Greg-R/T41_2_lpf/README.md

The documentation for this module is located here:

<https://kf5n.com/t41-2/t41-2_lpf/>
