Greg-R/T41_2_lpf/doc/T41_2_lpf.pdf

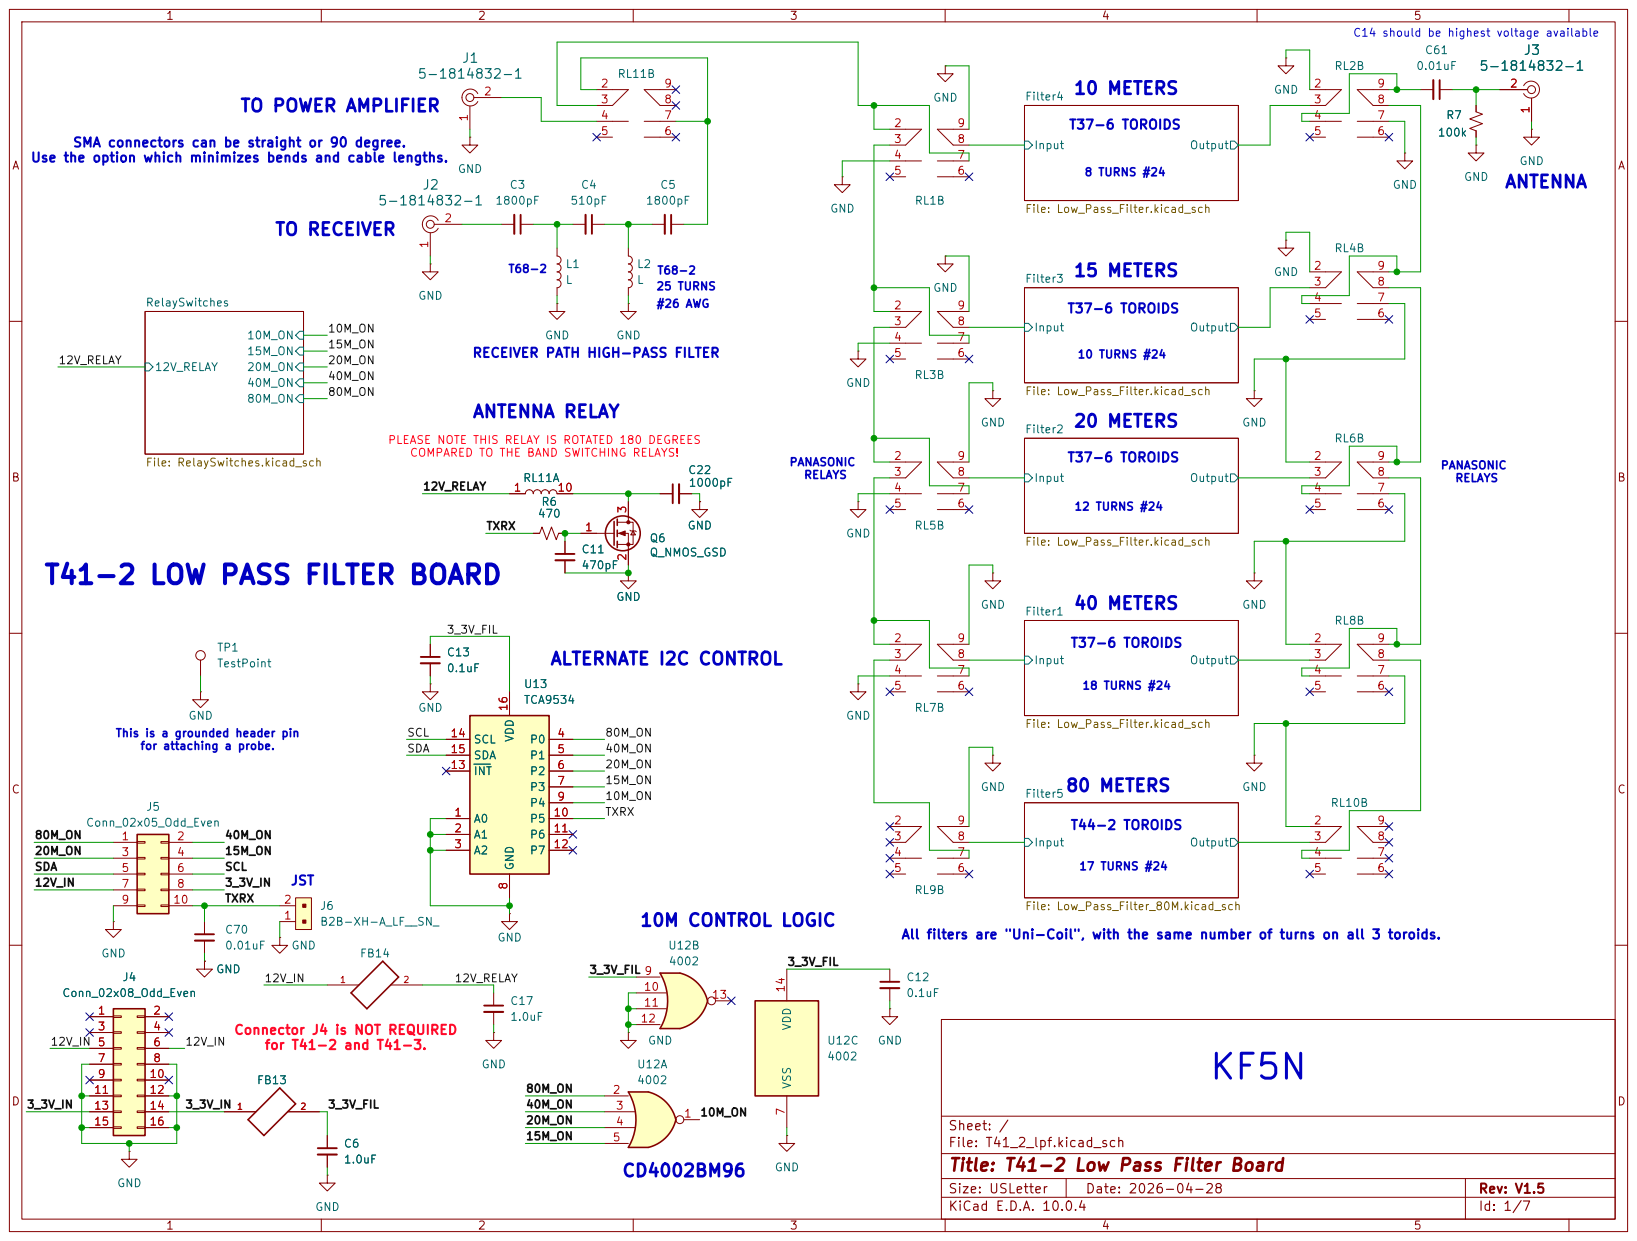
[picture p1: page 1]

C14 should be highest voltage available KF5N

SMA connectors can be straight or 90 degree.
Use the option which minimizes bends and cable lengths.

T68-2 ANTENNA RELAY
T68-2 RECEIVER PATH HIGH-PASS FILTER

T41-2 LOW PASS FILTER BOARD

This is a grounded header pin

All filters are "Uni-Coil", with the same number of turns on all 3 toroids.

Connector J4 is NOT REQUIRED
for T41-2 and T41-3.

Sheet: /
File: T41_2_lpf.kicad_sch
Title: T41-2 Low Pass Filter Board

Size: USLetter | Rev: V1.5
KiCad E.D.A. 10.0.4 | Id: 1/7

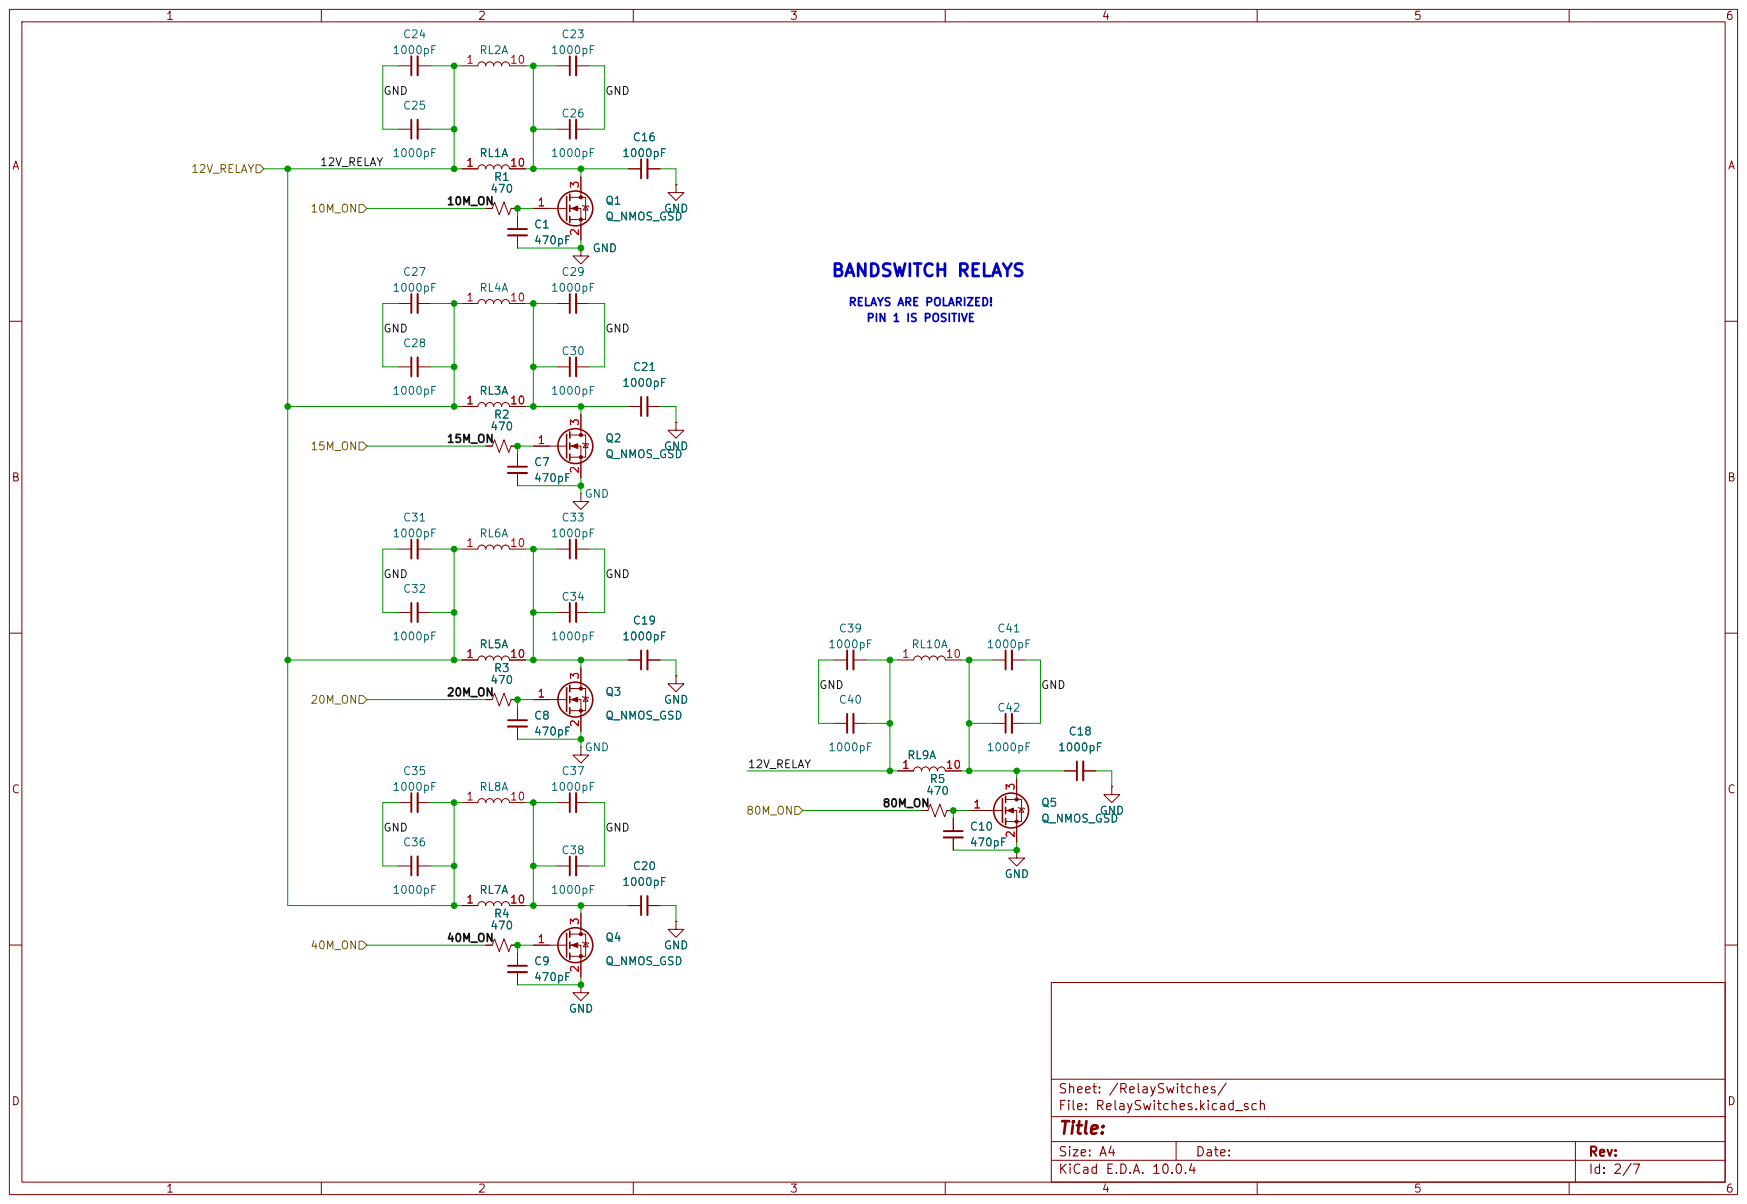
[picture p2: page 2]

RELAYS ARE POLARIZED! PIN 1 IS POSITIVE BANDSWITCH RELAYS

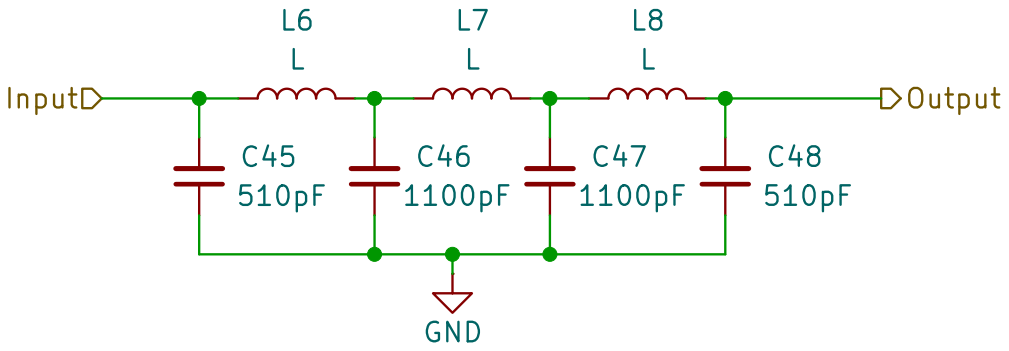
[picture p3: page 3]

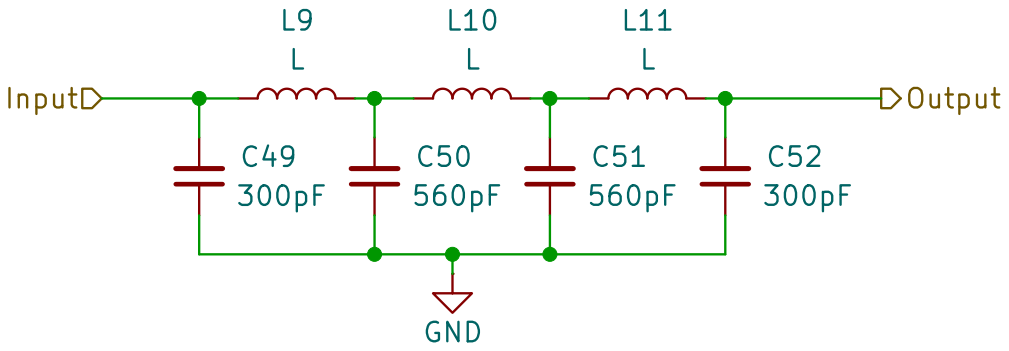
[picture p4: page 4]

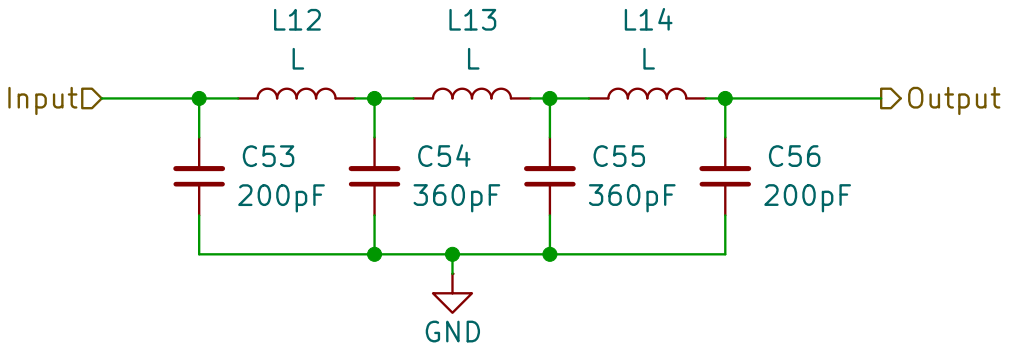
[picture p5: page 5]

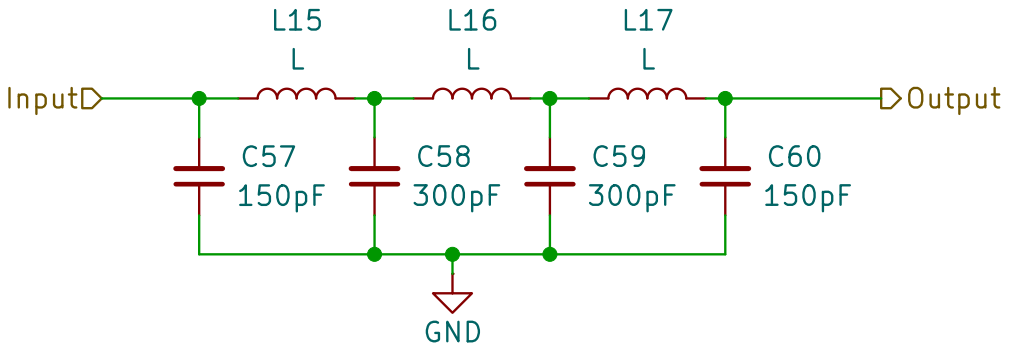
[picture p6: page 6]

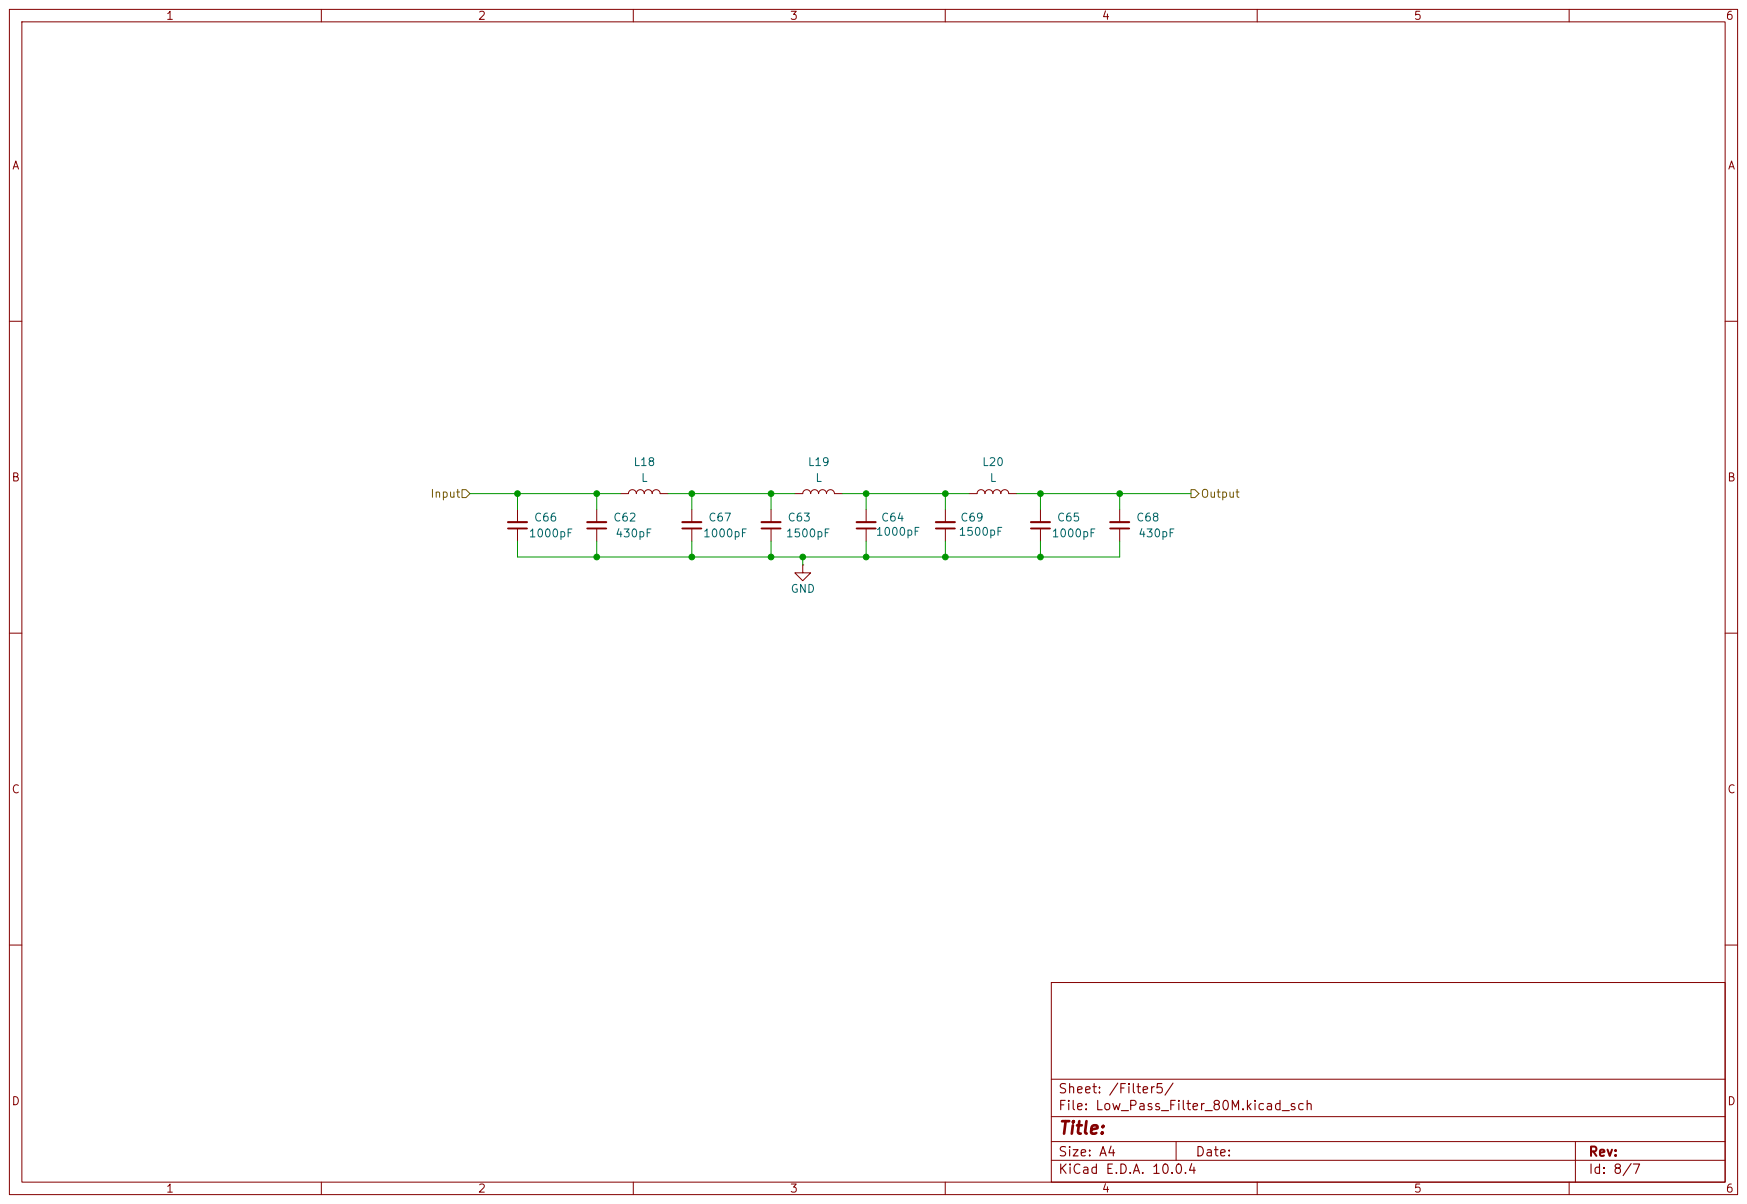
[picture p7: page 7]
