Greg-R/T41_2_lpf/(list of files, drawings)

Other design files:
T41_2_lpf.dsn
