Greg-R/T41_2_lpf/T41_2_lpf.kicad_pcb

## KiCad design T41_2_lpf.kicad_pcb (2026-07-20)

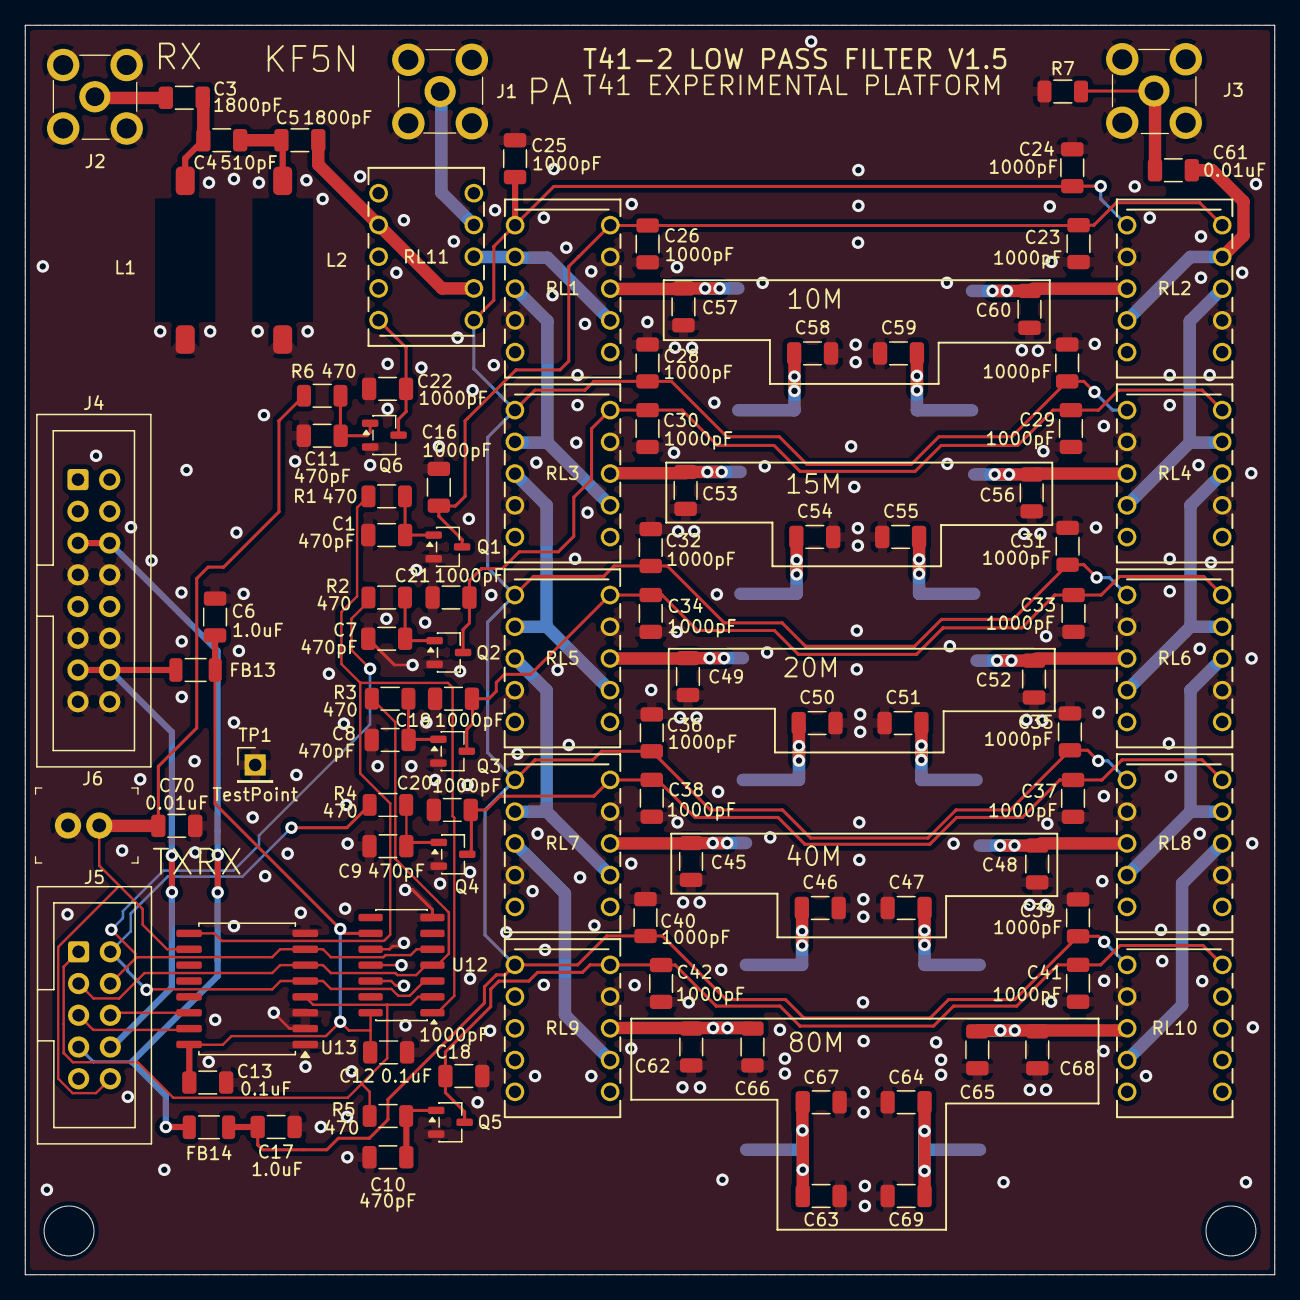
[picture p8: board T41_2_lpf.kicad_pcb from above]

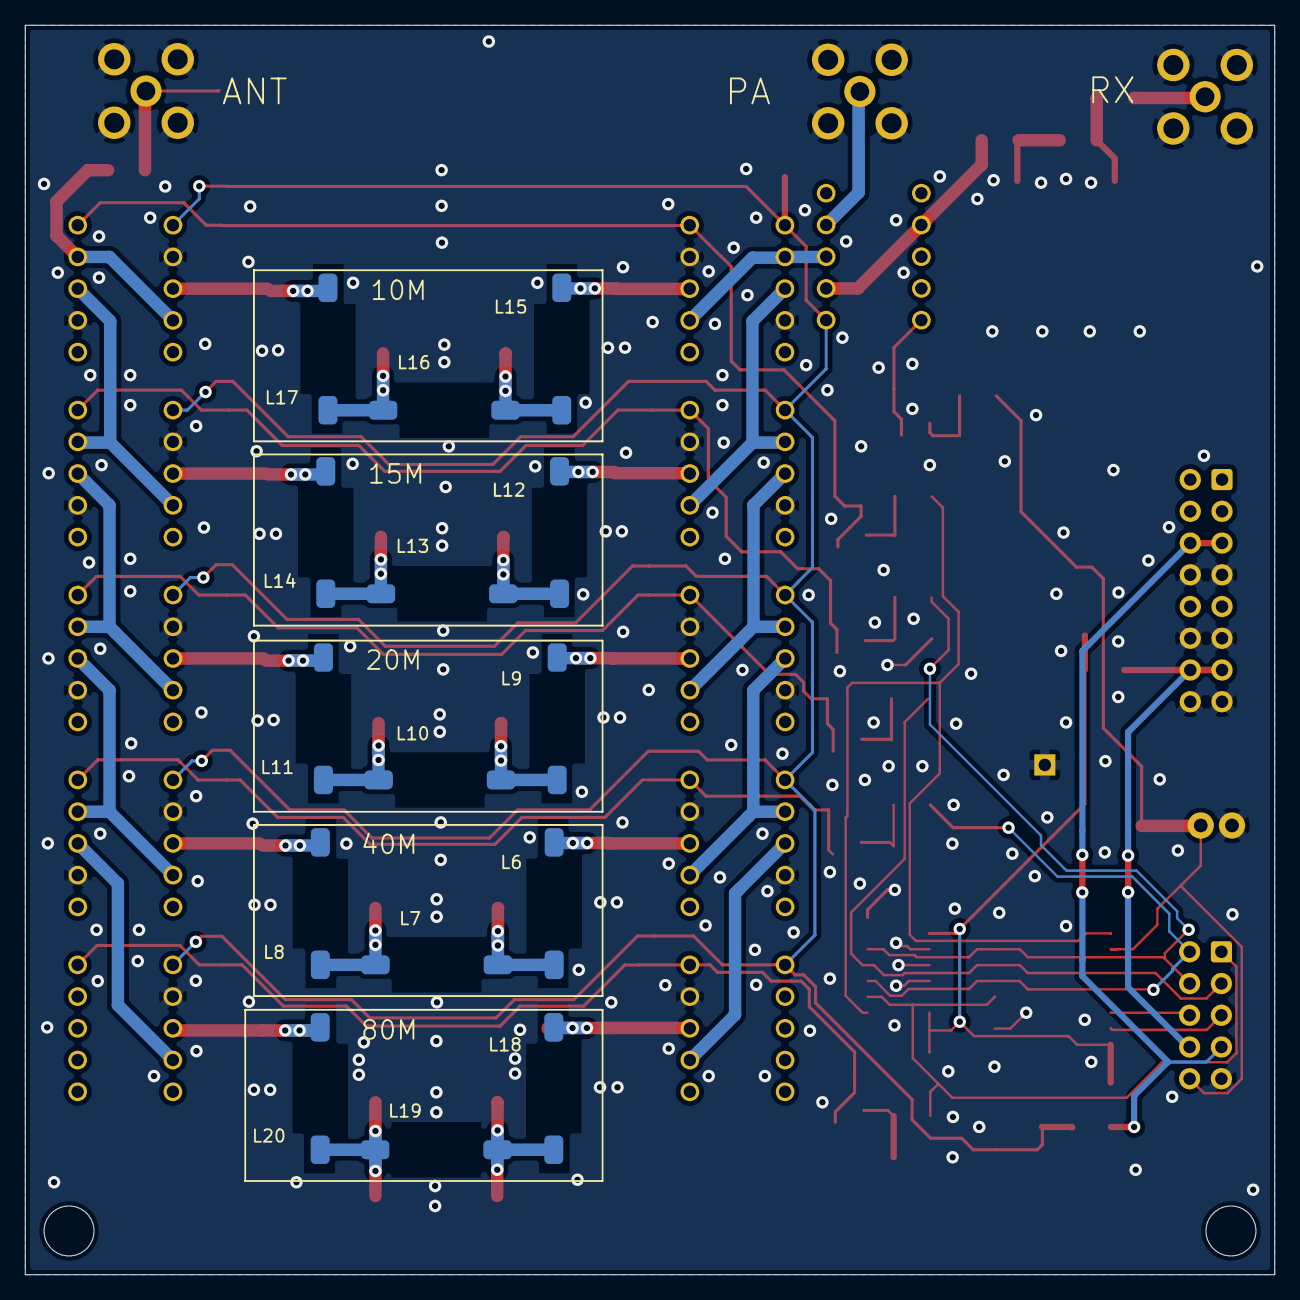
[picture p9: board T41_2_lpf.kicad_pcb from below]

Board: 2 copper layers, 100.0 x 100.0 mm, 117 parts (15 on the bottom side), 61 nets.

Parts:
C1, C7, C8, C9, C10, C11: 470pF; C_1206_3216Metric
C3, C5: 1800pF; C_1206_3216Metric
C4, C45, C48: 510pF; C_1206_3216Metric
C6, C17: 1.0uF; C_1206_3216Metric
C12, C13: 0.1uF; C_1206_3216Metric
C16, C18, C19, C20, C21, C22, C23, C24, C25, C26, C27, C28, C29, C30, C31, C32, C33, C34, C35, C36, C37, C38, C39, C40, C41, C42, C64, C65, C66, C67: 1000pF; C_1206_3216Metric
C46, C47: 1100pF; C_1206_3216Metric
C49, C52, C58, C59: 300pF; C_1206_3216Metric
C50, C51: 560pF; C_1206_3216Metric
C53, C56: 200pF; C_1206_3216Metric
C54, C55: 360pF; C_1206_3216Metric
C57, C60: 150pF; C_1206_3216Metric
C61, C70: 0.01uF; C_1206_3216Metric
C62, C68: 430pF; C_1206_3216Metric
C63, C69: 1500pF; C_1206_3216Metric
FB13, FB14: 28F0121-0SR-10; L_1206_3216Metric
J1, J2, J3: 5-1814832-1; RF_SMA_Vertical_5-1814832-1
J4: Conn_02x08_Odd_Even; IDC-Header_2x08_P2.54mm_Vertical
J5: Conn_02x05_Odd_Even; IDC-Header_2x05_P2.54mm_Vertical
J6: B2B-XH-A_LF__SN_; PinHeader_1x2_P2.5mm_Drill1.1mm
L1, L2: L; Toroid_SMD_T68
L6, L7, L8, L9, L10, L11, L12, L13, L14, L15, L16, L17, L18, L19, L20: L; Toroid_SMD_Thin
Q1, Q2, Q3, Q4, Q5, Q6: Q_NMOS_GSD; SOT-23-3
R1, R2, R3, R4, R5, R6: 470; R_1206_3216Metric
R7: 100k; R_1206_3216Metric
RL1, RL2, RL3, RL4, RL5, RL6, RL7, RL8, RL9, RL10, RL11: RELAY_TQ2_PAN
TP1: TestPoint; PinHeader_1x01_P2.54mm_Vertical
U12: 4002; SOIC-14_3.9x8.7mm_P1.27mm
U13: TCA9534; SOIC-16W_7.5x10.3mm_P1.27mm

Connections:
/3_3V_FIL: C6.1, C12.1, C13.1, FB13.2, U12.9, U12.14 (VDD), U13.16 (VDD)
/3_3V_IN: FB13.1, J4.13, J4.14, J5.8
/10M_ON: R1.1, U12.1, U13.9 (P4)
/12V_IN: FB14.1, J4.5, J4.6, J5.7
/12V_RELAY: C17.1, C24.2, C25.2, C27.2, C28.2, C31.2, C32.2, C35.2, C36.2, C39.2, C40.2, FB14.2, RL1.1, RL2.1, RL3.1, RL4.1, RL5.1, RL6.1, RL7.1, RL8.1, RL9.1, RL10.1, RL11.1
/15M_ON: J5.4, R2.1, U12.5, U13.7 (P3)
/20M_ON: J5.3, R3.1, U12.4, U13.6 (P2)
/40M_ON: J5.2, R4.1, U12.3, U13.5 (P1)
/80M_ON: J5.1, R5.1, U12.2, U13.4 (P0)
/Filter1/Input: C45.2, L6.1, RL7.8
/Filter1/Output: C48.2, L8.2, RL8.3
/Filter2/Input: C49.2, L9.1, RL5.8
/Filter2/Output: C52.2, L11.2, RL6.3
/Filter3/Input: C53.2, L12.1, RL3.8
/Filter3/Output: C56.2, L14.2, RL4.3
/Filter4/Input: C57.2, L15.1, RL1.8
/Filter4/Output: C60.2, L17.2, RL2.3
/Filter5/Input: C62.2, C66.2, L18.1, RL9.8
/Filter5/Output: C65.2, C68.2, L20.2, RL10.3
/SCL: J5.6, U13.14 (SCL)
/SDA: J5.5, U13.15 (SDA)
/TXRX: C70.1, J5.10, J6.2, R6.1, U13.10 (P5)
GND: C1.2, C6.2, C7.2, C8.2, C9.2, C10.2, C11.2, C12.2, C13.2, C16.2, C17.2, C18.2, C19.2, C20.2, C21.2, C22.2, C23.2, C24.1, C25.1, C26.2, C27.1, C28.1, C29.2, C30.2, C31.1, C32.1, C33.2, C34.2, C35.1, C36.1, C37.2, C38.2, C39.1, C40.1, C41.2, C42.2, C45.1, C46.1, C47.1, C48.1, C49.1, C50.1, C51.1, C52.1, C53.1, C54.1, C55.1, C56.1, C57.1, C58.1, C59.1, C60.1, C62.1, C63.1, C64.1, C65.1, C66.1, C67.1, C68.1, C69.1, C70.2, J1.1, J2.1, J3.1, J4.7, J4.8, J4.11, J4.12, J4.15, J4.16, J5.9, J6.1, L1.2, L2.2, Q1.2 (S), Q2.2 (S), Q3.2 (S), Q4.2 (S), Q5.2 (S), Q6.2 (S), R7.1, RL1.4, RL1.9, RL2.2, RL2.7, RL3.4, RL3.9, RL4.2, RL4.7, RL5.4, RL5.9, RL6.2, RL6.7, RL7.4, RL7.9, RL8.2, RL8.7, RL9.9, RL10.2, TP1.1 (1_1), U12.7 (VSS), U12.10, U12.11, U12.12, U13.1 (A0), U13.2 (A1), U13.3 (A2), U13.8 (GND)
unnamed: C3.1, C4.2, L1.1
unnamed: C3.2, J2.2
unnamed: C4.1, C5.2, L2.1
unnamed: C5.1, RL11.2, RL11.7
unnamed: C46.2, L6.2, L7.1
unnamed: C47.2, L7.2, L8.1
unnamed: C50.2, L9.2, L10.1
unnamed: C51.2, L10.2, L11.1
unnamed: C54.2, L12.2, L13.1
unnamed: C55.2, L13.2, L14.1
unnamed: C58.2, L15.2, L16.1
unnamed: C59.2, L16.2, L17.1
unnamed: C61.1, J3.2, R7.2
unnamed: C61.2, RL2.4, RL2.9
unnamed: C63.2, C67.2, L18.2, L19.1
unnamed: C64.2, C69.2, L19.2, L20.1
unnamed: J1.2, RL11.4
unnamed: C16.1, C23.1, C26.1, Q1.3 (D), RL1.10, RL2.10
unnamed: C1.1, Q1.1 (G), R1.2
unnamed: C21.1, C29.1, C30.1, Q2.3 (D), RL3.10, RL4.10
unnamed: C7.1, Q2.1 (G), R2.2
unnamed: C19.1, C33.1, C34.1, Q3.3 (D), RL5.10, RL6.10
unnamed: C8.1, Q3.1 (G), R3.2
unnamed: C20.1, C37.1, C38.1, Q4.3 (D), RL7.10, RL8.10
unnamed: C9.1, Q4.1 (G), R4.2
unnamed: C18.1, C41.1, C42.1, Q5.3 (D), RL9.10, RL10.10
unnamed: C10.1, Q5.1 (G), R5.2
unnamed: C22.1, Q6.3 (D), RL11.10
unnamed: C11.1, Q6.1 (G), R6.2
unnamed: RL1.2, RL1.7, RL11.3
unnamed: RL1.3, RL3.2, RL3.7
unnamed: RL2.8, RL4.4, RL4.9
unnamed: RL3.3, RL5.2, RL5.7
unnamed: RL4.8, RL6.4, RL6.9
unnamed: RL5.3, RL7.2, RL7.7
unnamed: RL6.8, RL8.4, RL8.9
unnamed: RL7.3, RL9.7
unnamed: RL8.8, RL10.4
