Greg-R/T41_2_lpf/doc/T41_2_lpf_cap_placement_guide.pdf

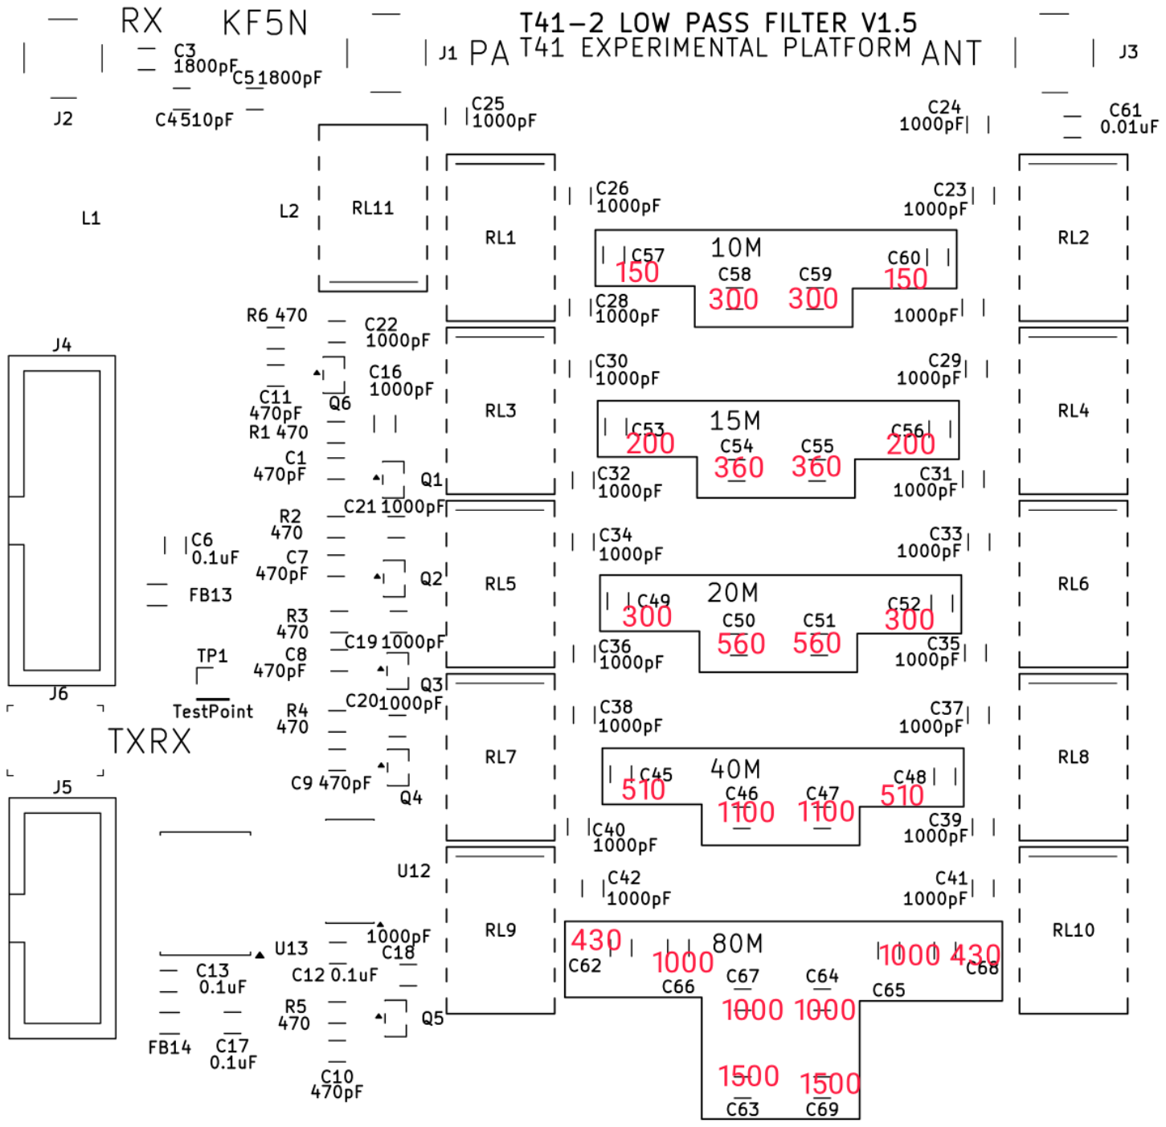
[picture p10: page 1]
