Greg-R/T41_2_lpf/(commit log)

2024-12-01 Initial commit.
    [10M_Filter.kicad_sch, 15M_Filter.kicad_sch, 20M_Filter.kicad_sch, 40M_Filter.kicad_sch, 80M_Filter.kicad_sch, Low_Pass_Filter.kicad_sch, RelaySwitches.kicad_sch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]
2024-12-02 Ready for fab.
    [T41_2_lpf-B_Cu.gbr, T41_2_lpf-B_Mask.gbr, T41_2_lpf-B_Silkscreen.gbr, T41_2_lpf-Edge_Cuts.gbr, T41_2_lpf-F_Cu.gbr, T41_2_lpf-F_Mask.gbr, T41_2_lpf-F_Silkscreen.gbr, T41_2_lpf-NPTH.drl]
2025-12-28 Commit just prior to pushing to Github. Design not complete.
    [Low_Pass_Filter.kicad_sch, RelaySwitches.kicad_sch, T41_2_lpf.kicad_pcb, T41_2_lpf.kicad_sch]
2026-03-15 Trying to improve schematic by adding capacitor values to all bands.
    [Low_Pass_Filter.kicad_sch, T41_2_lpf.kicad_sch]
2026-03-21 T41-2 LPF V1.4 to fab.
    [Low_Pass_Filter.kicad_sch, RelaySwitches.kicad_sch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]
2026-04-08 Work in progress just prior to publish.
    [Low_Pass_Filter.kicad_sch, RelaySwitches.kicad_sch, T41_2_lpf.kicad_sch]
2026-04-15 Ready to fab version 1.5
    [Low_Pass_Filter_80M.kicad_sch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]
2026-04-15 Updated versions on schematic and layout to V1.5.
    [T41_2_lpf.kicad_pcb, T41_2_lpf.kicad_sch]
2026-04-19 Ready to release V1.5 to fab.
    [T41_2_lpf-B_Cu.gbr, T41_2_lpf-B_Mask.gbr, T41_2_lpf-B_Silkscreen.gbr, T41_2_lpf-Edge_Cuts.gbr, T41_2_lpf-F_Cu.gbr, T41_2_lpf-F_Mask.gbr, T41_2_lpf-F_Silkscreen.gbr, T41_2_lpf-NPTH.drl]
2026-04-22 Schematic clean-up.
    [Low_Pass_Filter.kicad_sch, Low_Pass_Filter_80M.kicad_sch, T41_2_lpf.kicad_sch]
2026-04-22 Repository clean-up.
    [untitled.kicad_sch]
2026-04-23 More clean-up.
    [T41_2_lpf-B_Cu.gbr, T41_2_lpf-B_Mask.gbr, T41_2_lpf-B_Silkscreen.gbr, T41_2_lpf-Edge_Cuts.gbr, T41_2_lpf-F_Cu.gbr, T41_2_lpf-F_Mask.gbr, T41_2_lpf-F_Silkscreen.gbr, T41_2_lpf-NPTH.drl]
2026-04-23 Updated schematic PDF.
2026-04-24 Deleted extraneous schematic.
2026-04-28 Final clean-up.
    [T41_2_lpf.kicad_pcb, T41_2_lpf.kicad_sch]
2026-04-28 Finally ready to push.
    [T41_2_lpf.kicad_pcb, T41_2_lpf.kicad_sch]
2026-04-30 Had to make minor change to accomodate V10/V11 Main Board.
    [T41_2_lpf.kicad_pcb, T41_2_lpf.kicad_sch]
2026-04-30 Updated PDF schematic.
2026-07-20 Added bypass capacitor to TXRX. Did not uprev.
    [T41_2_lpf-B_Cu.gbr, T41_2_lpf-B_Mask.gbr, T41_2_lpf-B_Silkscreen.gbr, T41_2_lpf-Edge_Cuts.gbr, T41_2_lpf-F_Cu.gbr, T41_2_lpf-F_Mask.gbr, T41_2_lpf-F_Silkscreen.gbr, T41_2_lpf-NPTH.drl]
